nroggio/CafeSmart/README.md

# CafeSmart
Proyecto Laboratorio I - "Cafe Smart"

Este repositorio contiene el código y la documentación del proyecto Café Smart, un prototipo de cafetera de filtro transformada en una cafetera inteligente con conectividad Bluetooth, controlada mediante Arduino. El proyecto fue desarrollado como parte de la materia LAB I de nuestra carrera.

Integrantes: -Roggio Nicolas
             -Beresovski Ivan
             -Moyano Gonzalo

# Descripción del Proyecto
Café Smart es una cafetera que ha sido modificada para incluir características tales como:

Pantalla LCD para mostrar la cantidad de agua, el estado de la cafetera, la hora y mas detalles.
Conectividad Bluetooth para control remoto.
Programación de horarios para automatizar el encendido de la cafetera.
Medición precisa de agua.

El objetivo de este proyecto fue diseñar un prototipo funcional que cumpla con estas características mínimas, utilizando plataformas y tecnologías accesibles.

# Características Principales
Control por Arduino: Utilizamos un microcontrolador Arduino Uno para gestionar todas las funcionalidades de la cafetera.
Pantalla LCD: Muestra el estado del sistema, la cantidad de agua y otras informaciones relevantes.
Conexión Bluetooth: Implementada con un módulo HC-05 para el control remoto de la cafetera.
Programación de horarios: La cafetera puede programarse para encenderse a una hora específica mediante el RTC.
Tecnologías Utilizadas
Diseño 3D: Las piezas personalizadas para el prototipo fueron diseñadas en Fusion 360 y Tinkercad.
Lenguaje de Programación: El código del Arduino fue desarrollado en C y C++.
Simulación de Circuitos: Se utilizó Tinkercad para simular los circuitos antes de la implementación física.
Plataformas Colaborativas: Para la gestión de la información utilizamos OneDrive.
Repositorio GitHub: Todo el código y la documentación del proyecto están alojados en este repositorio.

# Instalación y Uso
Requisitos: 
- Arduino UNO o similar
- Módulo Bluetooth HC-05
- Pantalla LCD 20x4 I2C
- RTC DS1302
- Relé para control 
- Placa experimental
- Pila para RTC
- Pulsadores x3
- Tuercas y tornillos M3 x 12mm
- Cables y otros elementos

# Tutorial de armado

https://youtu.be/Svp_ZfF1dRw
