nroggio/CafeSmart/Diagrama electrico.pdf

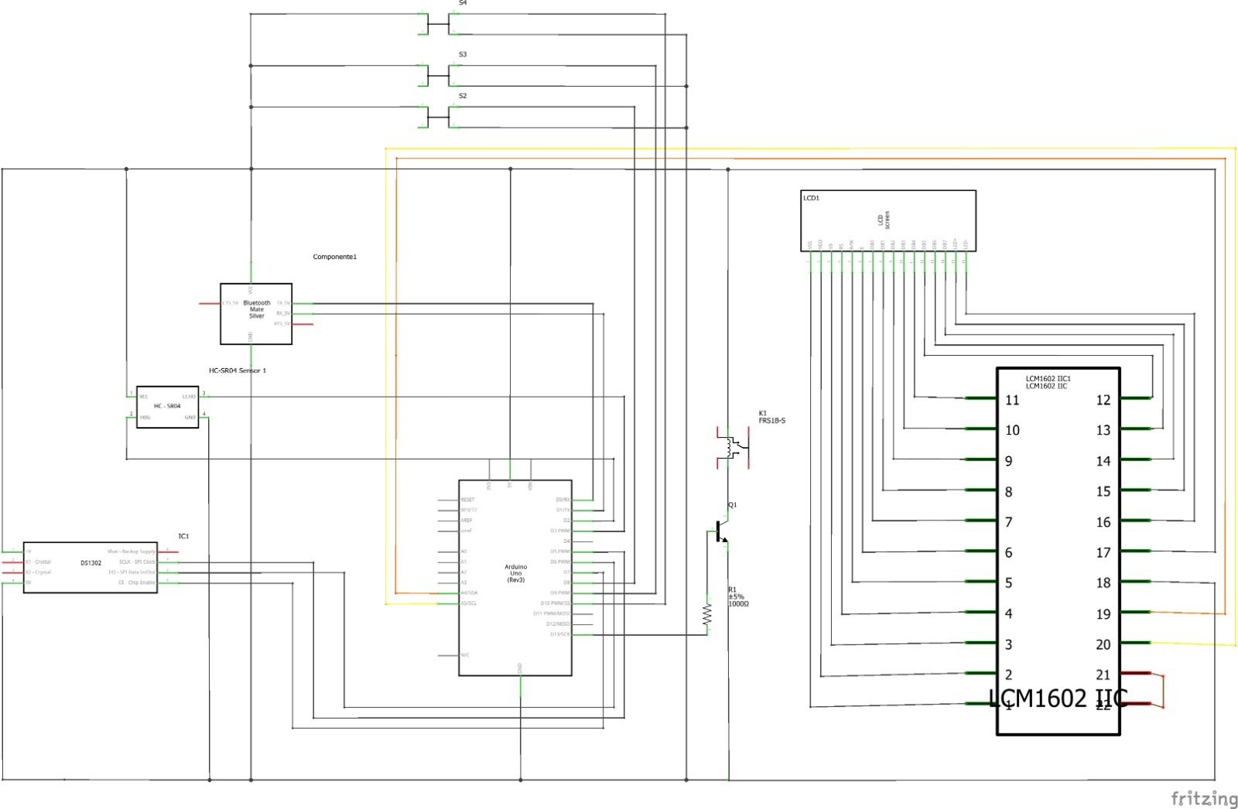
[picture p6: page 1]
