nroggio/CafeSmart/Archivos STL/Frente.stl

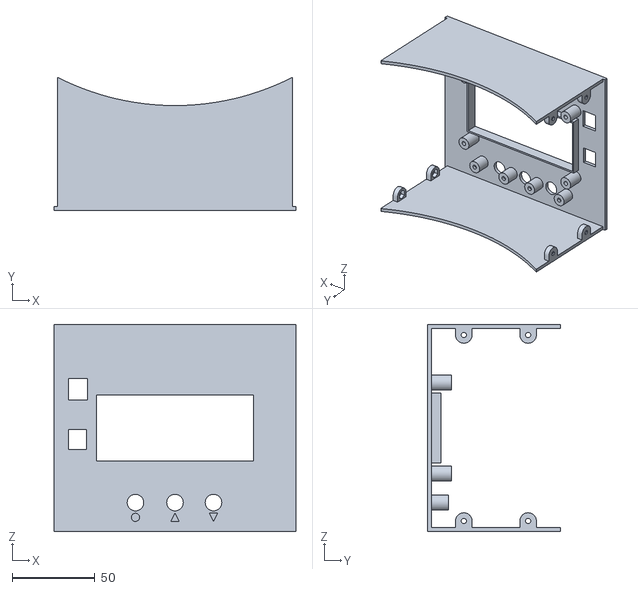
[picture p7: CAD file, 2024-11-07]
Archivos STL/Frente.stl
146.0 x 80.0 x 125.0
