nroggio/CafeSmart/Archivos STL/Botonera.stl

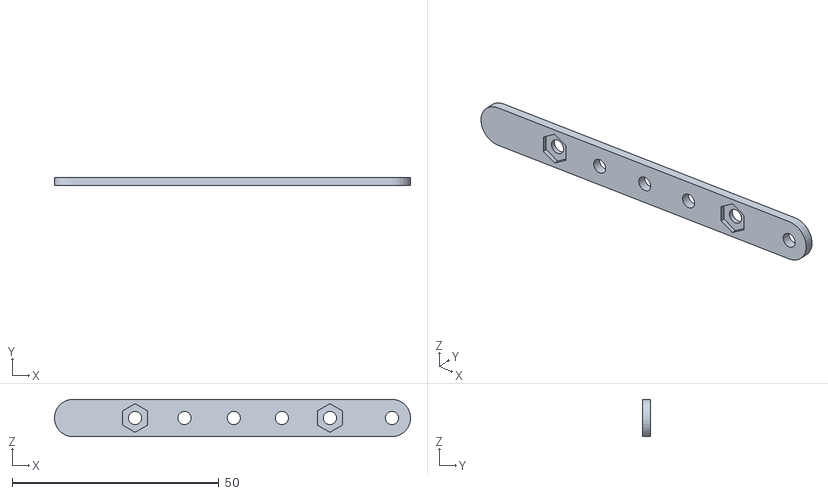
[picture p8: CAD file, 2024-11-07]
Archivos STL/Botonera.stl
86.0 x 2.00 x 9.00
