nroggio/CafeSmart/Archivos STL/Lateral Arduino.stl

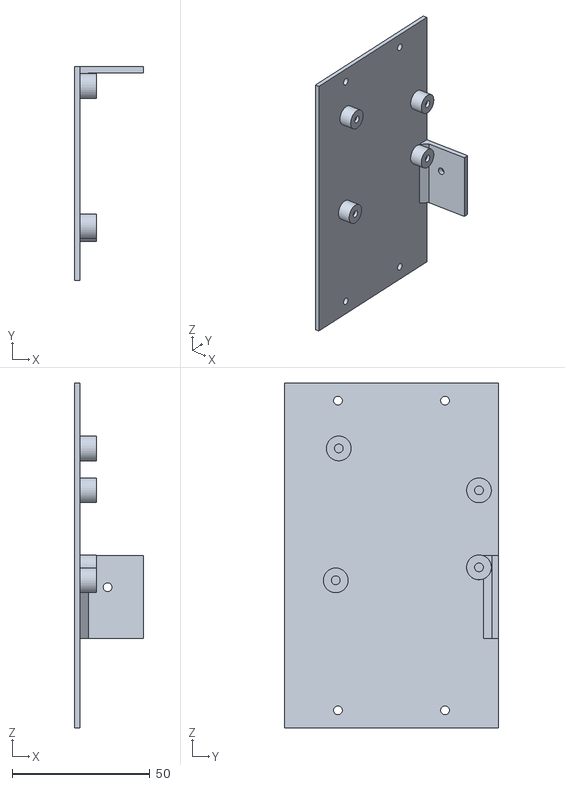
[picture p9: CAD file, 2024-11-07]
Archivos STL/Lateral Arduino.stl
25.0 x 77.6 x 125.0
