nroggio/CafeSmart/Archivos STL/Lateral simple.stl

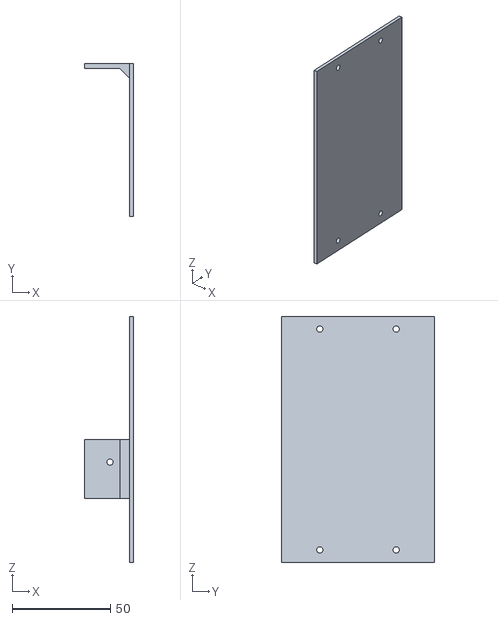
[picture p10: CAD file, 2024-11-07]
Archivos STL/Lateral simple.stl
25.0 x 77.6 x 125.0
